fablabnbg/aussentueren/README.md

# aussentueren
Hard- and Software for external doors of Hackerspaces
