fablabnbg/aussentueren/door_module/hardware/door_module.kicad_pcb

## KiCad design door_module/hardware/door_module.kicad_pcb (2023-12-17)

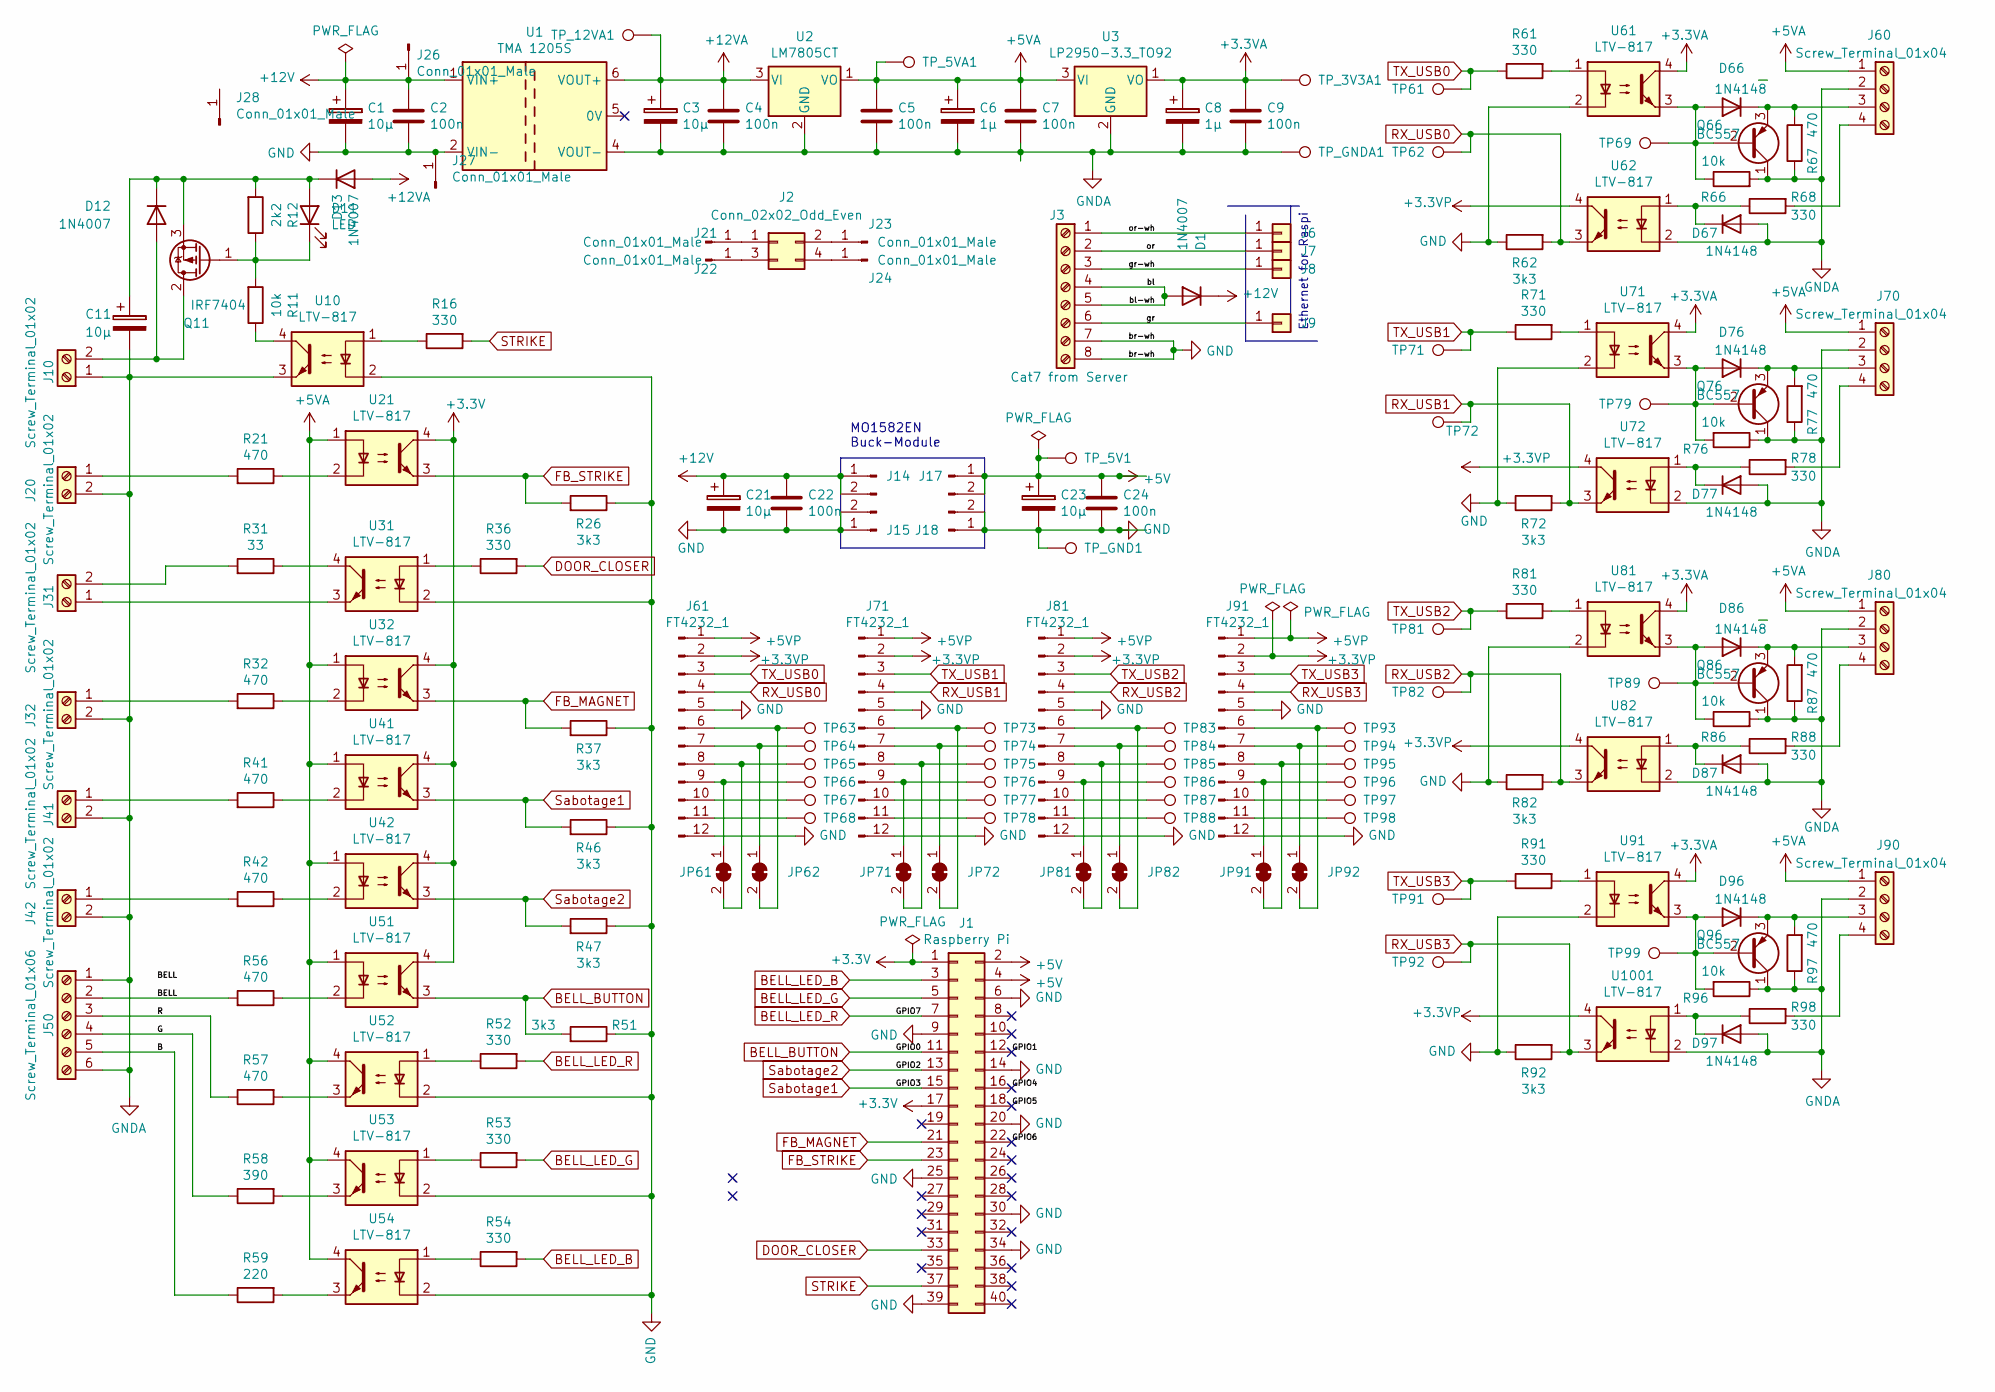
[picture p1: schematic door_module.kicad_sch]

Parts:
C1: 10µ; CP_Radial_D13.0mm_P7.50mm
C2, C4, C5, C7, C9: 100n; C_Disc_D3.0mm_W2.0mm_P2.50mm
C3, C11, C21, C23: 10µ; CP_Radial_D14.0mm_P7.50mm
C6: 1µ; CP_Radial_D5.0mm_P2.00mm
C8: 1µ; CP_Radial_Tantal_D5.5mm_P2.50mm
C22, C24: 100n; CP_Radial_D14.0mm_P7.50mm
D1, D12, D13: 1N4007; D_DO-41_SOD81_P10.16mm_Horizontal
D11: LED; LED_D5.0mm
D66, D67, D76, D77, D86, D87, D96, D97: 1N4148; D_DO-35_SOD27_P7.62mm_Horizontal
J1: Raspberry Pi; PinSocket_2x20_P2.54mm_Vertical
J2: Conn_02x02_Odd_Even; PinHeader_2x02_P2.54mm_Vertical
J3: Cat7 from Server; RJ45_Wuerth_7499010121A_Horizontal
J6, J7, J8, J9, J14, J15, J17, J18: SolderWirePad_1x02_P3.81mm_Drill0.8mm
J10, J20, J31, J32, J41, J42: Screw_Terminal_01x02; PhoenixContact_MSTBA_2,5_2-G-5,08_1x02_P5.08mm_Horizontal
J21, J22, J23, J24, J26, J27, J28: Conn_01x01_Male; PinHeader_1x01_P2.54mm_Vertical
J50: Screw_Terminal_01x06; PhoenixContact_MSTBA_2,5_6-G-5,08_1x06_P5.08mm_Horizontal
J60, J70, J80, J90: Screw_Terminal_01x04; PhoenixContact_MSTBA_2,5_4-G-5,08_1x04_P5.08mm_Horizontal
J61, J71, J81, J91: FT4232_1; PinSocket_1x12_P2.54mm_Vertical
JP61, JP62, JP71, JP72, JP81, JP82, JP91, JP92: SolderJumper_2_Bridged; SolderJumper-2_P1.3mm_Bridged_Pad1.0x1.5mm
Q11: IRF7404; TO-220-3_Vertical
Q66, Q76, Q86, Q96: BC557; TO-92_Inline
R11, R66, R76, R86, R96: 10k; R_Axial_DIN0207_L6.3mm_D2.5mm_P10.16mm_Horizontal
R12: 2k2; R_Axial_DIN0207_L6.3mm_D2.5mm_P10.16mm_Horizontal
R16, R36, R52, R53, R54, R61, R68, R71, R78, R81, R88, R91, R98: 330; R_Axial_DIN0207_L6.3mm_D2.5mm_P10.16mm_Horizontal
R21, R32, R41, R42, R56, R57, R67, R77, R87, R97: 470; R_Axial_DIN0207_L6.3mm_D2.5mm_P10.16mm_Horizontal
R26, R37, R46, R47, R51, R62, R72, R82, R92: 3k3; R_Axial_DIN0207_L6.3mm_D2.5mm_P10.16mm_Horizontal
R31: 33; R_Axial_DIN0207_L6.3mm_D2.5mm_P10.16mm_Horizontal
R58: 390; R_Axial_DIN0207_L6.3mm_D2.5mm_P10.16mm_Horizontal
R59: 220; R_Axial_DIN0207_L6.3mm_D2.5mm_P10.16mm_Horizontal
TP61, TP62, TP63, TP64, TP65, TP66, TP67, TP68, TP69, TP71, TP72, TP73, TP74, TP75, TP76, TP77, TP78, TP79, TP81, TP82, TP83, TP84, TP85, TP86, TP87, TP88, TP89, TP91, TP92, TP93, TP94, TP95, TP96, TP97, TP98, TP99: TestPoint; TestPoint_Loop_D1.80mm_Drill1.0mm_Beaded
TP_3V3A1, TP_5V1, TP_5VA1, TP_12VA1: TestPoint; TestPoint_Loop_D2.60mm_Drill1.6mm_Beaded
TP_GND1: TestPoint; TestPoint_Loop_D2.60mm_Drill1.6mm_Beaded
TP_GNDA1: TestPoint; TestPoint_Loop_D2.60mm_Drill1.6mm_Beaded
U1: TMA 1205S; SIP9_Housing_BigPads
U2: LM7805CT; TO-220-3_Vertical
U3: LP2950-3.3_TO92; TO-92_Inline
U10, U21, U31, U32, U41, U42, U51, U52, U53, U54, U61, U62, U71, U72, U81, U82, U91, U1001: LTV-817; DIP-4_W7.62mm

Connections:
+3.3VA: C8.1, C9.1, TP_3V3A1.1, U3.1 (VO), U61.4, U71.4, U81.4, U91.4
+3.3VP: J61.2, J71.2, J81.2, J91.2, U62.4, U72.4, U82.4, U1001.4
+3V3: J1.1, J1.17, U21.4, U32.4, U41.4, U42.4, U51.4
+5V: C23.1, C24.1, J1.2, J1.4, J17.1, J17.2, TP_5V1.1
+5VA: C5.1, C6.1, C7.1, J60.1, J70.1, J80.1, J90.1, TP_5VA1.1, U2.1 (VO), U3.3 (VI), U21.1, U32.1, U41.1, U42.1, U51.1, U52.4, U53.4, U54.4
+5VP: J61.1, J71.1, J81.1, J91.1
+12V: C1.1, C2.1, C21.1, C22.1, D1.1 (K), J14.1, J14.2, J26.1, U1.1 (VIN+)
+12VA: C3.1, C4.1, D13.2 (A), TP_12VA1.1, U1.6 (VOUT+), U2.3 (VI)
/B: J50.5, R59.1
/BELL: J50.2, R56.2
/G: J50.4, R58.1
/GPIO1: J1.12
/GPIO4: J1.16
/GPIO5: J1.18
/GPIO6: J1.22
/R: J50.3, R57.1
/bl: D1.2 (A), J3.4, J3.5
/gr: J3.6, J9.1
/gr-wh: J3.3, J8.1
/or: J3.2, J7.1
/or-wh: J3.1, J6.1
BELL_BUTTON: J1.11, R51.2, U51.3
BELL_LED_B: J1.3, R54.2
BELL_LED_G: J1.5, R53.2
BELL_LED_R: J1.7, R52.2
DOOR_CLOSER: J1.33, R36.2
FB_MAGNET: J1.21, R37.2, U32.3
FB_STRIKE: J1.23, R26.2, U21.3
GND: C1.2, C2.2, C21.2, C22.2, C23.2, C24.2, J1.6, J1.9, J1.14, J1.20, J1.25, J1.30, J1.34, J1.39, J3.7, J3.8, J15.1, J15.2, J18.1, J18.2, J27.1, J61.5, J61.12, J71.5, J71.12, J81.5, J81.12, J91.5, J91.12, R26.1, R37.1, R46.1, R47.1, R51.1, R62.1, R72.1, R82.1, R92.1, TP_GND1.1, U1.2 (VIN-), U10.2, U31.2, U52.2, U53.2, U54.2, U61.2, U71.2, U81.2, U91.2
GNDA: C3.2, C4.2, C5.2, C6.2, C7.2, C8.2, C9.2, C11.2, D67.2 (A), D77.2 (A), D87.2 (A), D97.2 (A), J10.1, J20.2, J32.2, J41.2, J42.2, J50.1, J50.6, J60.2, J70.2, J80.2, J90.2, Q66.1 (C), Q76.1 (C), Q86.1 (C), Q96.1 (C), R66.2, R67.1, R76.1, R77.1, R86.2, R87.1, R96.1, R97.1, TP_GNDA1.1, U1.4 (VOUT-), U2.2 (GND), U3.2 (GND), U10.3, U62.2, U72.2, U82.2, U1001.2
unnamed: C11.1, D11.2 (A), D12.1 (K), D13.1 (K), Q11.3 (S), R12.2
unnamed: D11.1 (K), Q11.1 (G), R11.2, R12.1
unnamed: D12.2 (A), J10.2, Q11.2 (D)
unnamed: D66.1 (K), J60.3, Q66.3 (E), R67.2
unnamed: D66.2 (A), Q66.2 (B), R66.1, TP69.1, U61.3
unnamed: D67.1 (K), R68.1, U62.1
unnamed: D76.1 (K), J70.3, Q76.3 (E), R77.2
unnamed: D76.2 (A), Q76.2 (B), R76.2, TP79.1, U71.3
unnamed: D77.1 (K), R78.1, U72.1
unnamed: D86.1 (K), J80.3, Q86.3 (E), R87.2
unnamed: D86.2 (A), Q86.2 (B), R86.1, TP89.1, U81.3
unnamed: D87.1 (K), R88.1, U82.1
unnamed: D96.1 (K), J90.3, Q96.3 (E), R97.2
unnamed: D96.2 (A), Q96.2 (B), R96.2, TP99.1, U91.3
unnamed: D97.1 (K), R98.1, U1001.1
unnamed: J2.1, J21.1
unnamed: J2.2, J23.1
unnamed: J2.3, J22.1
unnamed: J2.4, J24.1
unnamed: J20.1, R21.2
unnamed: J31.1, U31.3
unnamed: J31.2, R31.2
unnamed: J32.1, R32.2
unnamed: J41.1, R41.2
unnamed: J42.1, R42.2
unnamed: J60.4, R68.2
unnamed: J61.6, JP62.2 (B), TP63.1
unnamed: J61.7, JP62.1 (A), TP64.1
unnamed: J61.8, JP61.2 (B), TP65.1
unnamed: J61.9, JP61.1 (A), TP66.1
unnamed: J61.10, TP67.1
unnamed: J61.11, TP68.1
unnamed: J70.4, R78.2
unnamed: J71.6, JP72.2 (B), TP73.1
unnamed: J71.7, JP72.1 (A), TP74.1
unnamed: J71.8, JP71.2 (B), TP75.1
unnamed: J71.9, JP71.1 (A), TP76.1
unnamed: J71.10, TP77.1
unnamed: J71.11, TP78.1
unnamed: J80.4, R88.2
unnamed: J81.6, JP82.2 (B), TP83.1
unnamed: J81.7, JP82.1 (A), TP84.1
unnamed: J81.8, JP81.2 (B), TP85.1
unnamed: J81.9, JP81.1 (A), TP86.1
unnamed: J81.10, TP87.1
unnamed: J81.11, TP88.1
unnamed: J90.4, R98.2
unnamed: J91.6, JP92.2 (B), TP93.1
unnamed: J91.7, JP92.1 (A), TP94.1
unnamed: J91.8, JP91.2 (B), TP95.1
unnamed: J91.9, JP91.1 (A), TP96.1
unnamed: J91.10, TP97.1
unnamed: J91.11, TP98.1
unnamed: R11.1, U10.4
unnamed: R16.1, U10.1
unnamed: R21.1, U21.2
unnamed: R31.1, U31.4
unnamed: R32.1, U32.2
unnamed: R36.1, U31.1
unnamed: R41.1, U41.2
unnamed: R42.1, U42.2
unnamed: R52.1, U52.1
unnamed: R53.1, U53.1
unnamed: R54.1, U54.1
unnamed: R56.1, U51.2
unnamed: R57.2, U52.3
unnamed: R58.2, U53.3
unnamed: R59.2, U54.3
unnamed: R61.2, U61.1
unnamed: R71.2, U71.1
unnamed: R81.2, U81.1
unnamed: R91.2, U91.1
RX_USB0: J61.4, R62.2, TP62.1, U62.3
RX_USB1: J71.4, R72.2, TP72.1, U72.3
RX_USB2: J81.4, R82.2, TP82.1, U82.3
RX_USB3: J91.4, R92.2, TP92.1, U1001.3
STRIKE: J1.37, R16.2
Sabotage1: J1.15, R46.2, U41.3
Sabotage2: J1.13, R47.2, U42.3
TX_USB0: J61.3, R61.1, TP61.1
TX_USB1: J71.3, R71.1, TP71.1
TX_USB2: J81.3, R81.1, TP81.1
TX_USB3: J91.3, R91.1, TP91.1

Notes on the sheet:
MO1582EN Buck-Module
Ethernet for Raspi

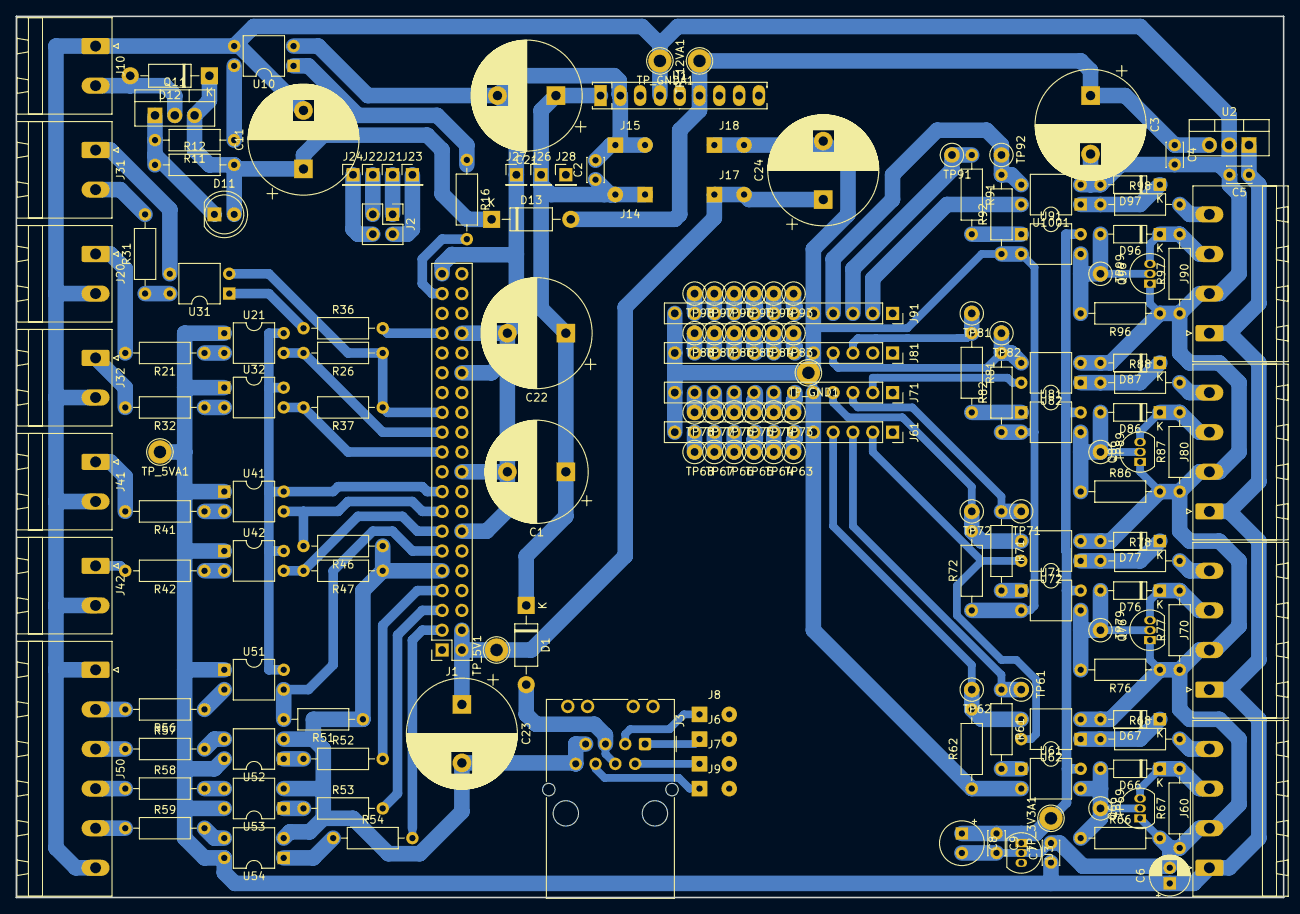
[picture p2: board door_module.kicad_pcb from above]

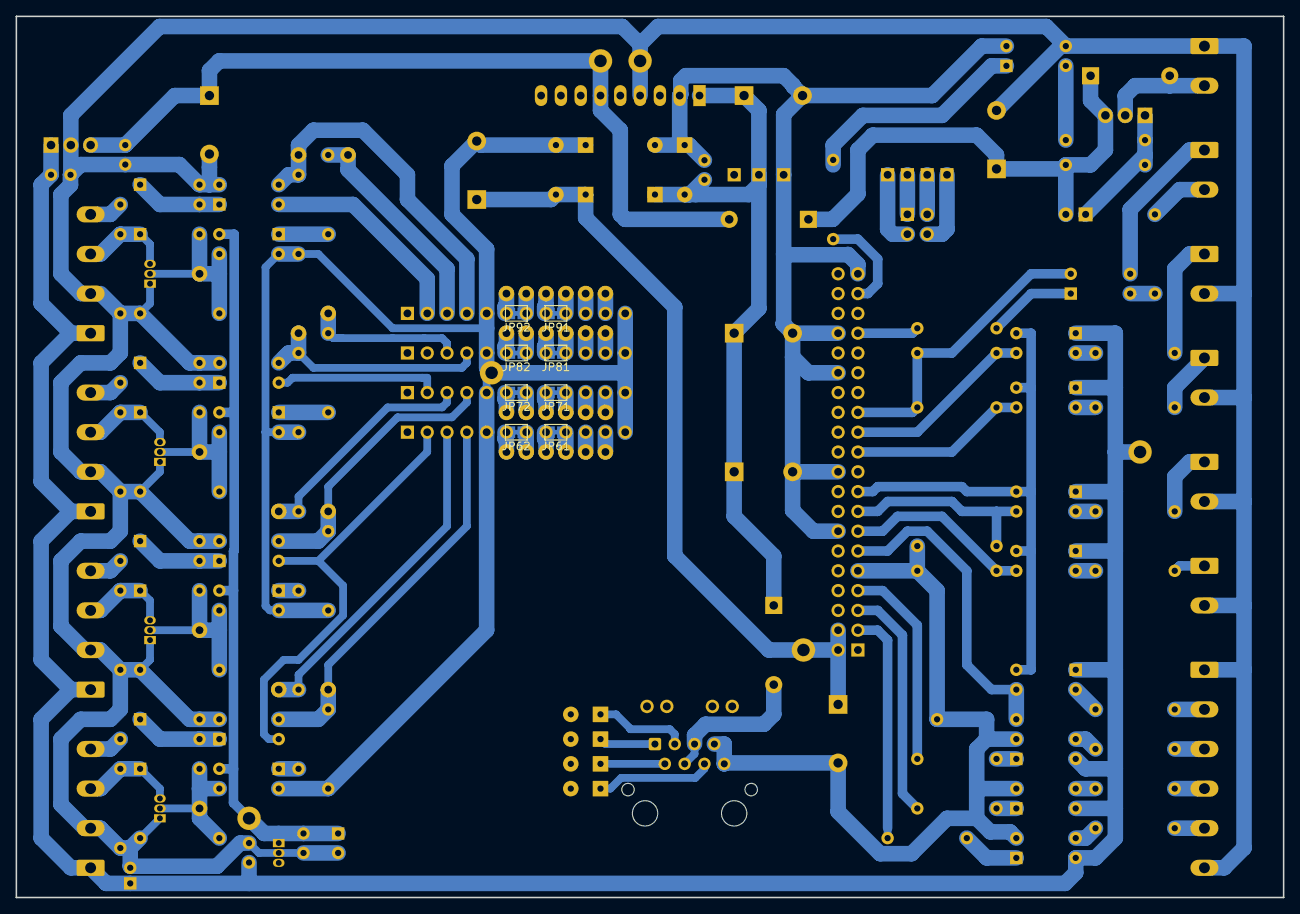
[picture p3: board door_module.kicad_pcb from below]

Board: 2 copper layers, 162.6 x 113.0 mm, 176 parts (8 on the bottom side), 109 nets.
