fablabnbg/aussentueren/(threads)

Thread 1 (2019-02-03):

Input on all serial devices should be rate limited

IVI053, 2019-02-03:
To prevent brute force attacks on serial devices that are not safe from manipulation there should be a rate limit on accepted input to prevent automated attacks.

Thread 3 (2019-11-04):

crypted communication to server

Krufto, 2019-11-04:
to prevent a "man in the middle attack" the communication between server and client should be encoded.

IVI053, 2019-11-05:
The message payload utilizes HMAC. This prevents replay attacks. Interception of communication to gain information about cards and PINs is a possible thread but limited as network between server and client is a physically separated network.
But it should still be a easy improvement to activate MQTTS in mosquitto using TLS.

Thread 4 (2019-11-04):

open communication between keypad, RFID Scanner and client

Krufto, 2019-11-04:
The communication between RFID scanner -> client and keypad -> client are not encrypted. An attacker can simply record the communication and login with the wrong identity.

To protect the communication it need to be encrypted.

IVI053, 2019-11-05:
As encryption has only limited impact in the event of physical attacks on hardware I suppose to implement intrusion detection to detect tinkering with the devices. If a possible attack is detected the corresponding device should be treated as unsafe until marked as safe by a trusted person.

Thread 8 (2019-11-05):

Multiple function breaking bugs in PCB layout

IVI053, 2019-11-05:
- [ ] U1 (TMA 1212S) is undersized and releases all magic smoke on latching
- [ ] All GPIO on J1 are incorrectly named
- [ ] R11 is wrong and should be connected between gate of Q11 and D11. Gate Q11 needs to be connected to U21 directly
- [ ] Some nets are not connected and air wires are left unrouted
- [ ] GND is sometimes only connected through RPi which is bad practice and should be avoided.
- [ ] opti-isolators for RGB-LED are for a common cathode LED but a common anode LED is build into the bell switch

Thread 12 (2020-07-08):

5 Volt Supply

Krufto, 2020-07-08:
**U2** is largly undersiced and need to be adjusted.
The Voltage regulator **U2** supports all extern devices with power. For each normal Arduino it need to deliver 30mA and for each Arduino with RFID Sensor it needs 60mA and 120mA Peak current. In our current setup we need at least 150mA and 270mA Peak.

For Future development the voltage regulator should deliver a constant current from about 300mA and Peak of 400mA
