fablabnbg/aussentueren/door_module/software/parameters.py

same_card_delay_seconds=2
max_cards_per_second=2
max_delay_card_pin_seconds=10
tunes={
    'pin':[0b11010101,0b11000001],
    'deny':[0b11010101,0b11000001],
    'attention':[0b11010101,0b11000001],
    'keypress':[0b11010101,0b11000001],
    'confirm':[0b11010101,0b11000001],
    }
