fablabnbg/aussentueren/(commit log)

2019-02-02 Add missing imported file
    [identity_store.py]
2019-02-02 Fix midding argument in on_message callback of mqtt
    [mqtt.py]
2019-02-03 Send card shown message after pin entry
2019-02-03 Fix beeping in terpreter
    [interpreter.py]
2019-02-03 First WIP version
    [door_module.kicad_pcb, door_module.sch]
2019-02-03 Fix variable name of validator in server mqtt
    [mqtt.py]
2019-02-03 Fix hmac calculation after validator move
    [mqtt.py]
2019-02-09 Add tests for pin handling
2019-02-09 Cleanup imports in pin.py
2019-03-09 Small initial changes to Schematic
    [door_module.sch]
2019-03-09 Finalized Alpha Version of Door-Module Schematic
    [door_module.sch]
2019-03-10 Change: buffered serial outputs Change: PoE added 25k Resistor Add: Test points Add: Annotations and Values Change: Tidy up things a little
    [door_module.sch]
2019-03-11 First Placement of door_module PCB Minor changes to schematic
    [door_module.kicad_pcb, door_module.sch]
2019-03-11 Some more Groups on the door_module PCB
    [door_module.kicad_pcb]
2019-04-10 First alpha PCB
    [door_module.kicad_pcb, door_module.sch]
2019-11-05 Use logging module instead of prints
2019-11-17 Fixing PIN change to actually work
    [interpreter.py, mqtt.py]
2023-11-30 -mod: Changed U2 VoltegeRegulatior to LM7805CT
    [door_module.kicad_pcb, door_module.kicad_sch]
